Manawyrm/HB-LC-DimPWM-PCB/gerbers/RevA/HB-LC-DimPWM-PCB.png

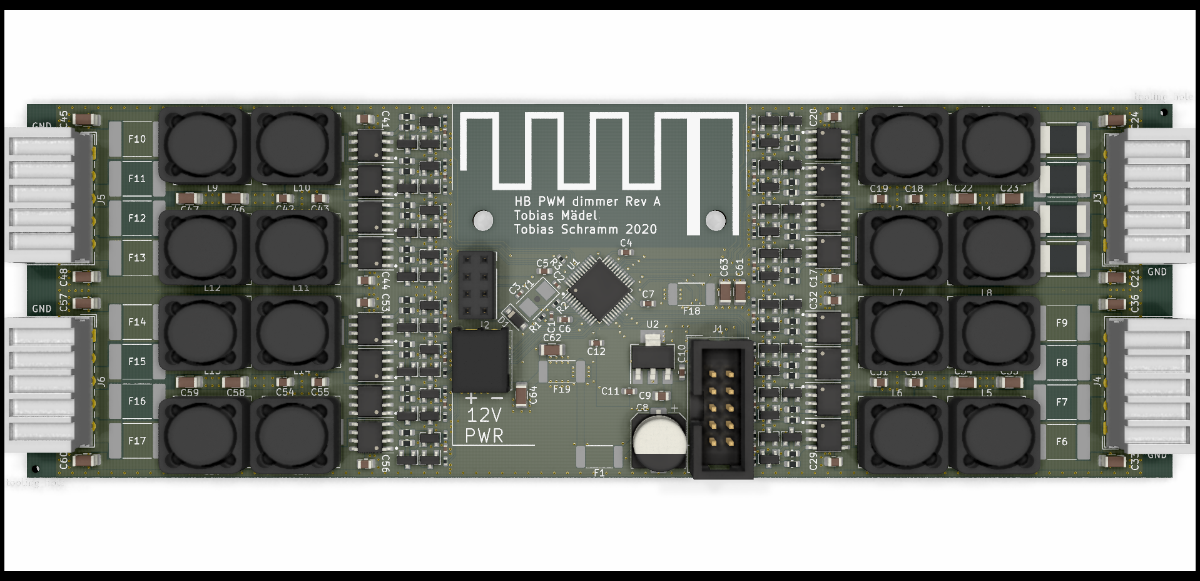
gerbers/RevA/HB-LC-DimPWM-PCB.png
