Manawyrm/HB-LC-DimPWM-PCB/README.md

HomeBrew 16 channel dimmer
==========================
