Manawyrm/HB-LC-DimPWM-PCB/HB-LC-DimPWM-PCB.kicad_pcb

## KiCad design HB-LC-DimPWM-PCB.kicad_pcb (2020-04-15)

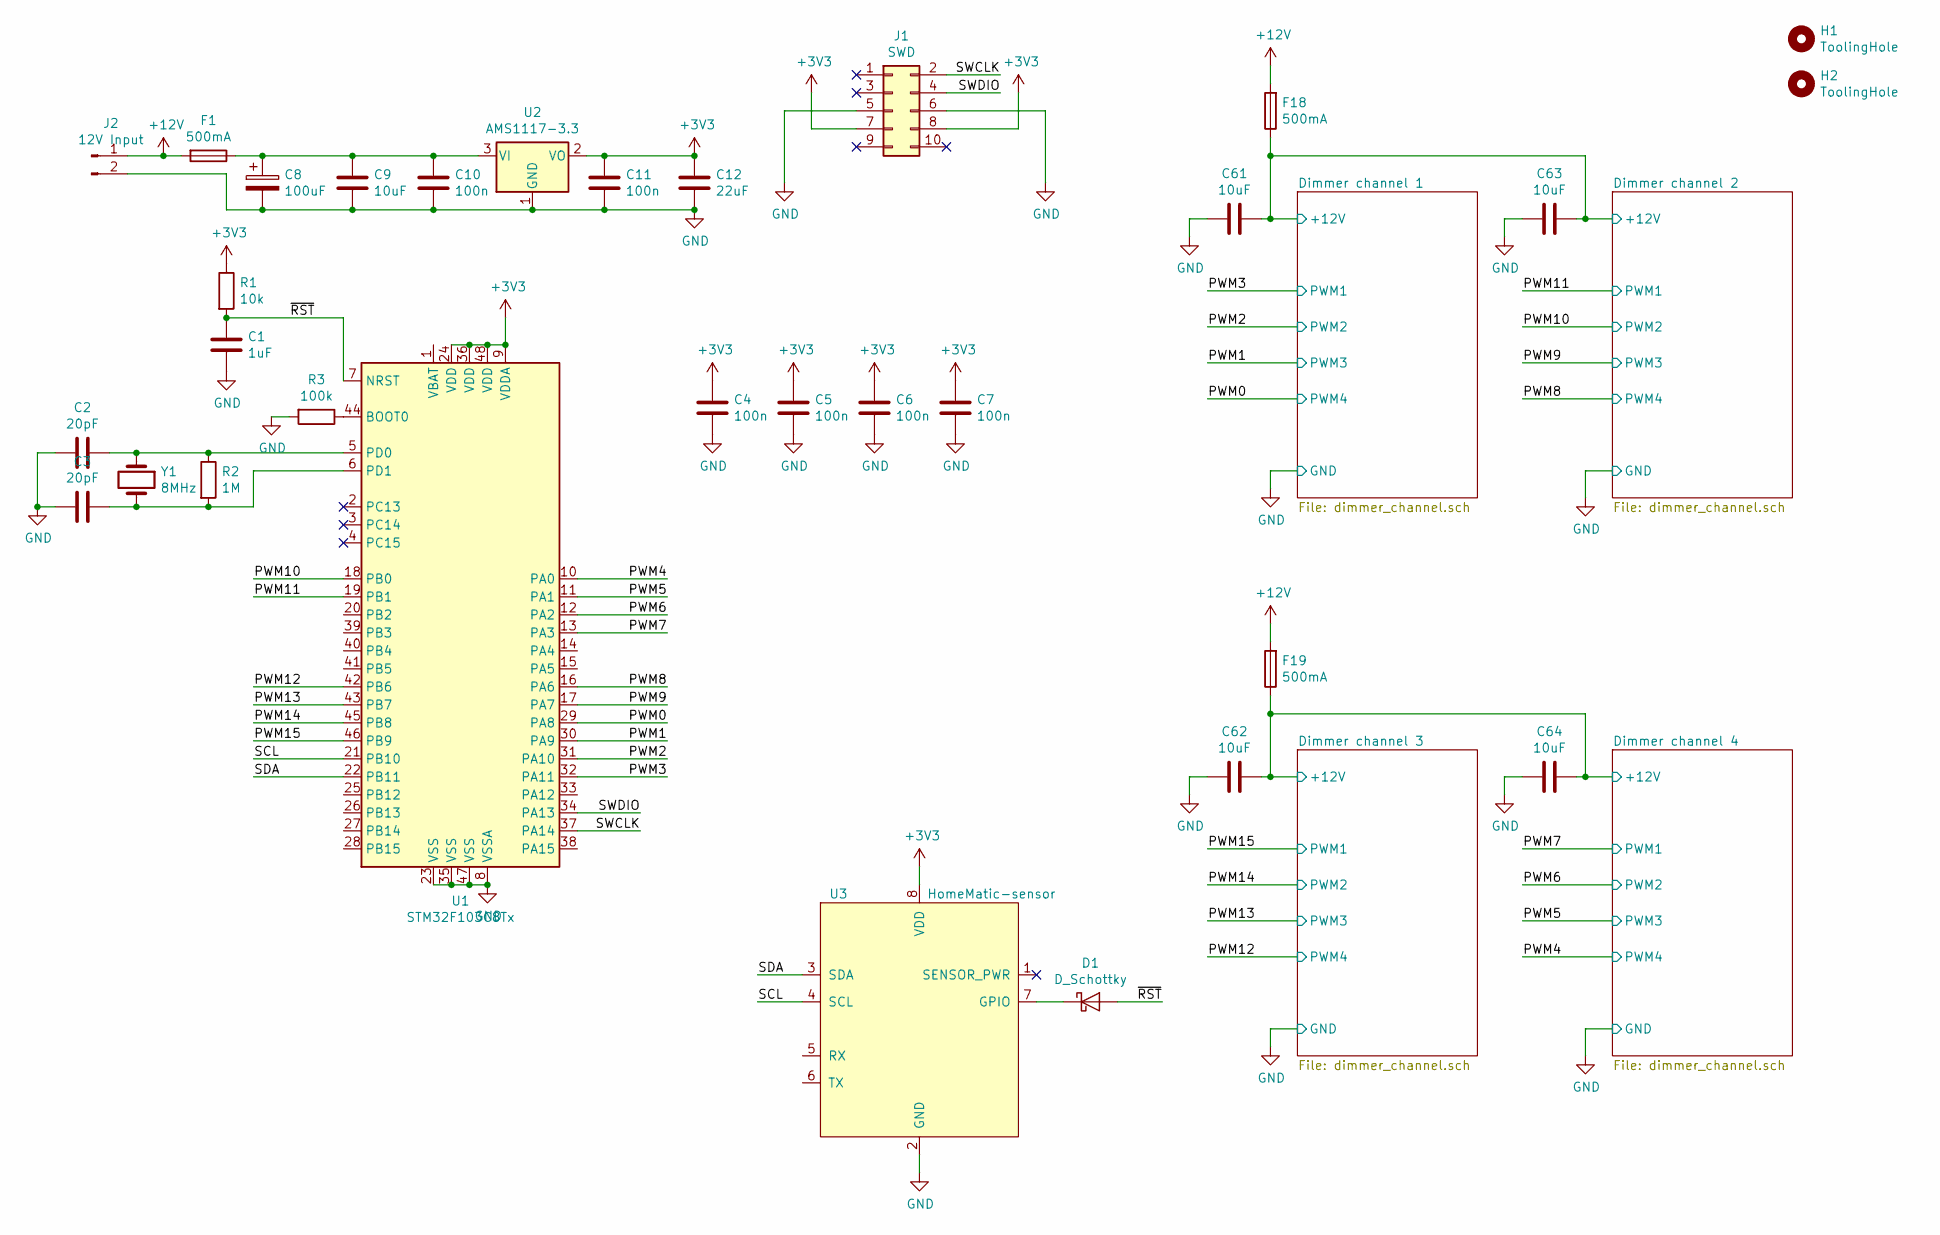
[picture p7: schematic HB-LC-DimPWM-PCB.sch, HB-LC-DimPWM]

Parts:
C1: 1uF; C_0402_1005Metric; LCSC C52923
C2, C3: 20pF; C_0402_1005Metric; LCSC C1554
C4, C5, C6, C7, C10, C11: 100n; C_0603_1608Metric; LCSC C14663
C8: 100uF; CP_Elec_8x6.7; LCSC C127967
C9: 10uF; C_0805_2012Metric; LCSC C15850
C12: 22uF; C_0603_1608Metric; LCSC C59461
C61, C62, C63, C64: 10uF; C_1206_3216Metric; LCSC C13585
D1: D_Schottky; D_SOD-123; LCSC C8598
F1, F18, F19: 500mA; Fuse_2512_6332Metric; LCSC C312001
H1, H2: ToolingHole; ToolingHole_JLCSMT
J1: SWD; IDC-Header_2x05_P2.54mm_Vertical
J2: 12V Input; Wago_714-162_1x02_P3.50mm_Horizontal
R1: 10k; R_0402_1005Metric; LCSC C25744
R2: 1M; R_0402_1005Metric; LCSC C26083
R3: 100k; R_0402_1005Metric; LCSC C25741
U1: STM32F103C8Tx; LQFP-48_7x7mm_P0.5mm; LCSC C8734
U2: AMS1117-3.3; SOT-223-3_TabPin2; LCSC C6186
U3: HomeMatic-sensor
Y1: 8MHz; Crystal_SMD_5032-2Pin_5.0x3.2mm; LCSC C115962

Connections:
+3V3: C4.1, C5.1, C6.1, C7.1, C11.1, C12.1, J1.7, J1.8, R1.1, U1.9 (VDDA), U1.24 (VDD), U1.36 (VDD), U1.48 (VDD), U2.2 (VO), U3.8 (VDD)
+12V: F1.2, F18.2, F19.2, J2.1
/Dimmer channel 1/+12V: C61.1, C63.1, F18.1; also elsewhere on the board
/Dimmer channel 3/+12V: C62.1, C64.1, F19.1; also elsewhere on the board
/PWM0: U1.29 (PA8); also elsewhere on the board
/PWM1: U1.30 (PA9); also elsewhere on the board
/PWM2: U1.31 (PA10); also elsewhere on the board
/PWM3: U1.32 (PA11); also elsewhere on the board
/PWM4: U1.10 (PA0); also elsewhere on the board
/PWM5: U1.11 (PA1); also elsewhere on the board
/PWM6: U1.12 (PA2); also elsewhere on the board
/PWM7: U1.13 (PA3); also elsewhere on the board
/PWM8: U1.16 (PA6); also elsewhere on the board
/PWM9: U1.17 (PA7); also elsewhere on the board
/PWM10: U1.18 (PB0); also elsewhere on the board
/PWM11: U1.19 (PB1); also elsewhere on the board
/PWM12: U1.42 (PB6); also elsewhere on the board
/PWM13: U1.43 (PB7); also elsewhere on the board
/PWM14: U1.45 (PB8); also elsewhere on the board
/PWM15: U1.46 (PB9); also elsewhere on the board
/SCL: U1.21 (PB10), U3.4 (SCL)
/SDA: U1.22 (PB11), U3.3 (SDA)
/SWCLK: J1.2, U1.37 (PA14)
/SWDIO: J1.4, U1.34 (PA13)
/~RST: C1.1, D1.2 (A), R1.2, U1.7 (NRST)
GND: C1.2, C2.1, C3.1, C4.2, C5.2, C6.2, C7.2, C8.2, C9.2, C10.2, C11.2, C12.2, C61.2, C62.2, C63.2, C64.2, J1.5, J1.6, J2.2, R3.2, U1.8 (VSSA), U1.23 (VSS), U1.35 (VSS), U1.47 (VSS), U2.1 (GND), U3.2 (GND); also elsewhere on the board
unnamed: C2.2, R2.1, U1.5 (PD0), Y1.1
unnamed: C3.2, R2.2, U1.6 (PD1), Y1.2
unnamed: C8.1, C9.1, C10.1, F1.1, U2.3 (VI)
unnamed: D1.1 (K), U3.7 (GPIO)
unnamed: R3.1, U1.44 (BOOT0)

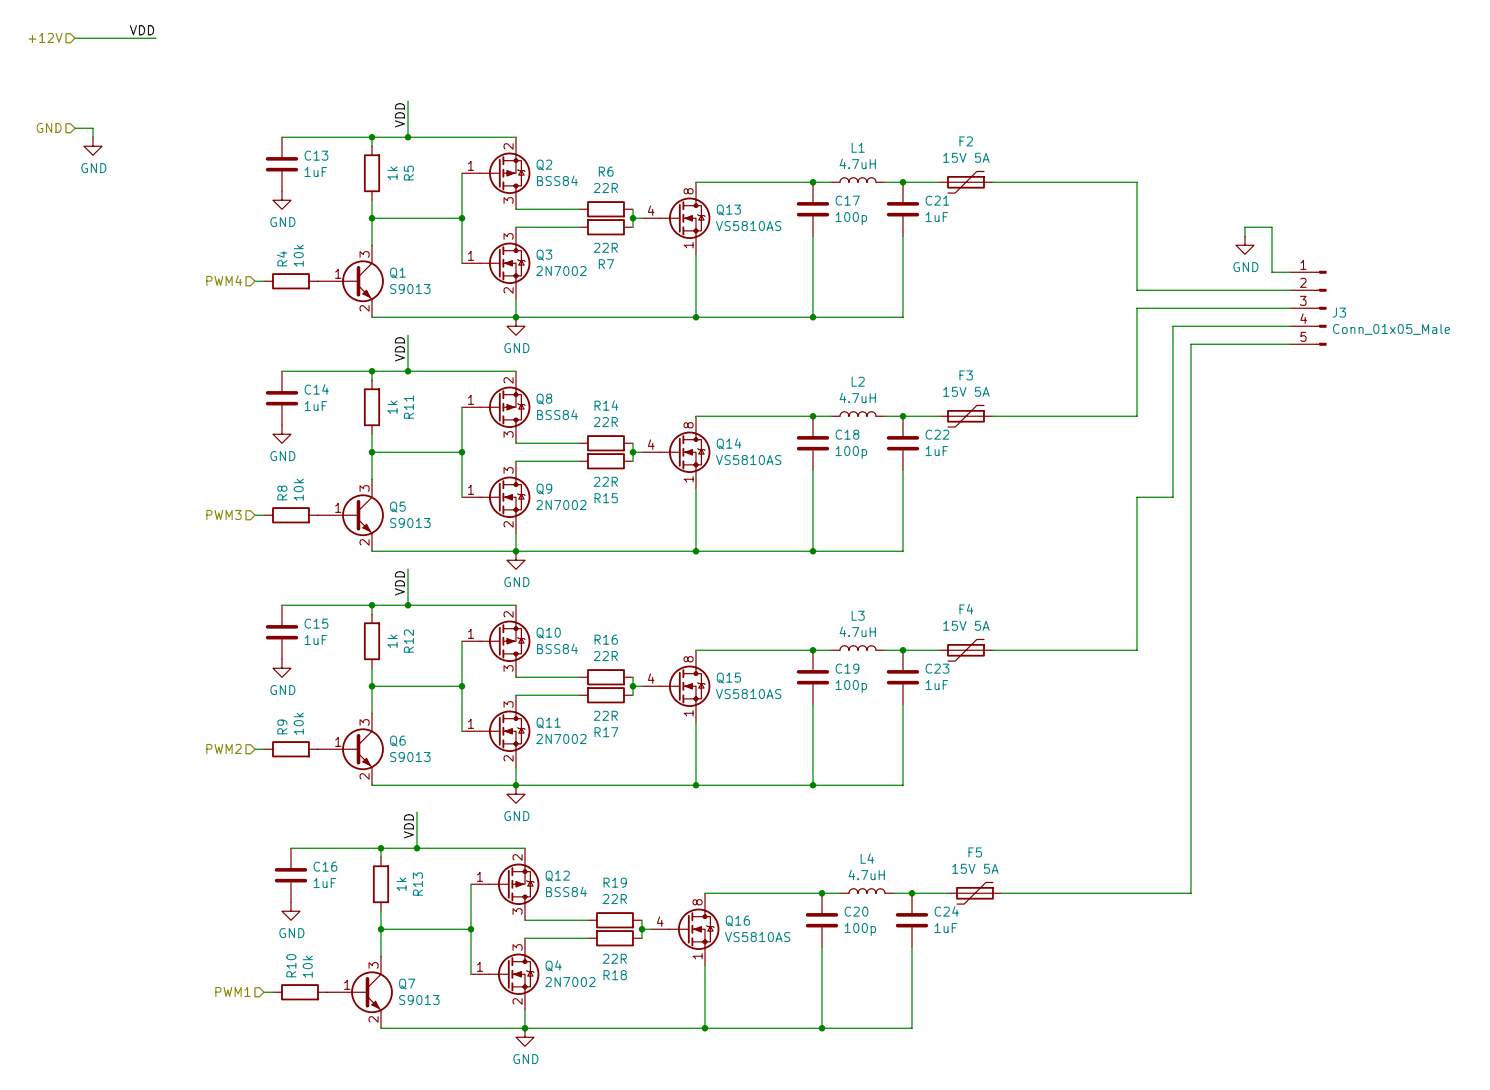
[picture p8: schematic dimmer_channel.sch, Dimmer channel]

Parts:
C13, C14, C15, C16: 1uF; C_0402_1005Metric; LCSC C52923
C17, C18, C19, C20: 100p; C_0805_2012Metric; LCSC C1790
C21, C22, C23, C24: 1uF; C_1206_3216Metric; LCSC C1848
F2, F3, F4, F5: 15V 5A; Fuse_2920_7451Metric; LCSC C207089
J3: Conn_01x05_Male; Wago_734-165_1x05_P3.50mm_Horizontal
L1, L2, L3, L4: 4.7uH; SMD-PIND-10.5x11.5x4_2.5x3.0; LCSC C183899
Q1, Q5, Q6, Q7: S9013; SOT-23; LCSC C6749
Q2, Q8, Q10, Q12: BSS84; SOT-23; LCSC C8492
Q3, Q4, Q9, Q11: 2N7002; SOT-23; LCSC C8545
Q13, Q14, Q15, Q16: VS5810AS; SOIC-8_3.9x4.9mm_P1.27mm; LCSC C427034
R4, R8, R9, R10: 10k; R_0402_1005Metric; LCSC C25744
R5, R11, R12, R13: 1k; R_0402_1005Metric; LCSC C11702
R6, R7, R14, R15, R16, R17, R18, R19: 22R; R_0603_1608Metric; LCSC C23345

Connections:
/Dimmer channel 1/+12V: C13.1, C14.1, C15.1, C16.1, Q2.2 (S), Q8.2 (S), Q10.2 (S), Q12.2 (S), R5.2, R11.2, R12.2, R13.2; also elsewhere on the board
/PWM0: R4.1; also elsewhere on the board
/PWM1: R8.1; also elsewhere on the board
/PWM2: R9.1; also elsewhere on the board
/PWM3: R10.1; also elsewhere on the board
GND: C13.2, C14.2, C15.2, C16.2, C17.2, C18.2, C19.2, C20.2, C21.2, C22.2, C23.2, C24.2, J3.1, Q1.2 (E), Q3.2 (S), Q4.2 (S), Q5.2 (E), Q6.2 (E), Q7.2 (E), Q9.2 (S), Q11.2 (S), Q13.1 (S), Q13.2 (S), Q13.3 (S), Q14.1 (S), Q14.2 (S), Q14.3 (S), Q15.1 (S), Q15.2 (S), Q15.3 (S), Q16.1 (S), Q16.2 (S), Q16.3 (S); also elsewhere on the board
unnamed: C17.1, L1.1, Q13.5 (D), Q13.6 (D), Q13.7 (D), Q13.8 (D)
unnamed: C18.1, L2.1, Q14.5 (D), Q14.6 (D), Q14.7 (D), Q14.8 (D)
unnamed: C19.1, L3.1, Q15.5 (D), Q15.6 (D), Q15.7 (D), Q15.8 (D)
unnamed: C20.1, L4.1, Q16.5 (D), Q16.6 (D), Q16.7 (D), Q16.8 (D)
unnamed: C21.1, F2.2, L1.2
unnamed: C22.1, F3.2, L2.2
unnamed: C23.1, F4.2, L3.2
unnamed: C24.1, F5.2, L4.2
unnamed: F2.1, J3.2
unnamed: F3.1, J3.3
unnamed: F4.1, J3.4
unnamed: F5.1, J3.5
unnamed: Q1.1 (B), R4.2
unnamed: Q1.3 (C), Q2.1 (G), Q3.1 (G), R5.1
unnamed: Q2.3 (D), R6.1
unnamed: Q3.3 (D), R7.2
unnamed: Q4.3 (D), R18.2
unnamed: Q5.1 (B), R8.2
unnamed: Q5.3 (C), Q8.1 (G), Q9.1 (G), R11.1
unnamed: Q6.1 (B), R9.2
unnamed: Q7.1 (B), R10.2
unnamed: Q8.3 (D), R14.1
unnamed: Q9.3 (D), R15.2
unnamed: Q6.3 (C), Q10.1 (G), Q11.1 (G), R12.1
unnamed: Q10.3 (D), R16.1
unnamed: Q11.3 (D), R17.2
unnamed: Q4.1 (G), Q7.3 (C), Q12.1 (G), R13.1
unnamed: Q12.3 (D), R19.1
unnamed: Q13.4 (G), R6.2, R7.1
unnamed: Q14.4 (G), R14.2, R15.1
unnamed: Q15.4 (G), R16.2, R17.1
unnamed: Q16.4 (G), R18.1, R19.2

Parts of its further copies:
C25, C26, C27, C28, C37, C38, C39, C40, C49, C50, C51, C52: 1uF; C_0402_1005Metric; LCSC C52923
C29, C30, C31, C32, C41, C42, C43, C44, C53, C54, C55, C56: 100p; C_0805_2012Metric; LCSC C1790
C33, C34, C35, C36, C45, C46, C47, C48, C57, C58, C59, C60: 1uF; C_1206_3216Metric; LCSC C1848
F6, F7, F8, F9, F10, F11, F12, F13, F14, F15, F16, F17: 15V 5A; Fuse_2920_7451Metric; LCSC C207089
J4, J5, J6: Conn_01x05_Male; Wago_734-165_1x05_P3.50mm_Horizontal
Q17, Q18, Q19, Q20, Q33, Q34, Q35, Q36, Q49, Q50, Q51, Q52: S9013; SOT-23; LCSC C6749
Q21, Q23, Q25, Q27, Q37, Q39, Q41, Q43, Q53, Q55, Q57, Q59: BSS84; SOT-23; LCSC C8492
Q22, Q24, Q26, Q28, Q38, Q40, Q42, Q44, Q54, Q56, Q58, Q60: 2N7002; SOT-23; LCSC C8545
Q29, Q30, Q31, Q32, Q45, Q46, Q47, Q48, Q61, Q62, Q63, Q64: VS5810AS; SOIC-8_3.9x4.9mm_P1.27mm; LCSC C427034
R20, R21, R22, R23, R36, R37, R38, R39, R52, R53, R54, R55: 10k; R_0402_1005Metric; LCSC C25744
R24, R25, R26, R27, R40, R41, R42, R43, R56, R57, R58, R59: 1k; R_0402_1005Metric; LCSC C11702
R28, R29, R30, R31, R32, R33, R34, R35, R44, R45, R46, R47, R48, R49, R50, R51, R60, R61, R62, R63, R64, R65, R66, R67: 22R; R_0603_1608Metric; LCSC C23345

Connections of its further copies:
/Dimmer channel 1/+12V: C25.1, C26.1, C27.1, C28.1, Q21.2 (S), Q23.2 (S), Q25.2 (S), Q27.2 (S), R24.2, R25.2, R26.2, R27.2; also elsewhere on the board
/Dimmer channel 3/+12V: C37.1, C38.1, C39.1, C40.1, C49.1, C50.1, C51.1, C52.1, Q37.2 (S), Q39.2 (S), Q41.2 (S), Q43.2 (S), Q53.2 (S), Q55.2 (S), Q57.2 (S), Q59.2 (S), R40.2, R41.2, R42.2, R43.2, R56.2, R57.2, R58.2, R59.2; also elsewhere on the board
/PWM4: R52.1; also elsewhere on the board
/PWM5: R53.1; also elsewhere on the board
/PWM6: R54.1; also elsewhere on the board
/PWM7: R55.1; also elsewhere on the board
/PWM8: R20.1; also elsewhere on the board
/PWM9: R21.1; also elsewhere on the board
/PWM10: R22.1; also elsewhere on the board
/PWM11: R23.1; also elsewhere on the board
/PWM12: R36.1; also elsewhere on the board
/PWM13: R37.1; also elsewhere on the board
/PWM14: R38.1; also elsewhere on the board
/PWM15: R39.1; also elsewhere on the board
GND: C25.2, C26.2, C27.2, C28.2, C29.2, C30.2, C31.2, C32.2, C33.2, C34.2, C35.2, C36.2, C37.2, C38.2, C39.2, C40.2, C41.2, C42.2, C43.2, C44.2, C45.2, C46.2, C47.2, C48.2, C49.2, C50.2, C51.2, C52.2, C53.2, C54.2, C55.2, C56.2, C57.2, C58.2, C59.2, C60.2, J4.1, J5.1, J6.1, Q17.2 (E), Q18.2 (E), Q19.2 (E), Q20.2 (E), Q22.2 (S), Q24.2 (S), Q26.2 (S), Q28.2 (S), Q29.1 (S), Q29.2 (S), Q29.3 (S), Q30.1 (S), Q30.2 (S), Q30.3 (S), Q31.1 (S), Q31.2 (S), Q31.3 (S), Q32.1 (S), Q32.2 (S), Q32.3 (S), Q33.2 (E), Q34.2 (E), Q35.2 (E), Q36.2 (E), Q38.2 (S), Q40.2 (S), Q42.2 (S), Q44.2 (S), Q45.1 (S), Q45.2 (S), Q45.3 (S), Q46.1 (S), Q46.2 (S), Q46.3 (S), Q47.1 (S), Q47.2 (S), Q47.3 (S), Q48.1 (S), Q48.2 (S), Q48.3 (S), Q49.2 (E), Q50.2 (E), Q51.2 (E), Q52.2 (E), Q54.2 (S), Q56.2 (S), Q58.2 (S), Q60.2 (S), Q61.1 (S), Q61.2 (S), Q61.3 (S), Q62.1 (S), Q62.2 (S), Q62.3 (S), Q63.1 (S), Q63.2 (S), Q63.3 (S), Q64.1 (S), Q64.2 (S), Q64.3 (S); also elsewhere on the board
unnamed 37: C29.1, Q29.5 (D), Q29.6 (D), Q29.7 (D), Q29.8 (D); also elsewhere on the board
unnamed 38: C30.1, Q30.5 (D), Q30.6 (D), Q30.7 (D), Q30.8 (D); also elsewhere on the board
unnamed 39: C31.1, Q31.5 (D), Q31.6 (D), Q31.7 (D), Q31.8 (D); also elsewhere on the board
unnamed 40: C32.1, Q32.5 (D), Q32.6 (D), Q32.7 (D), Q32.8 (D); also elsewhere on the board
unnamed 41: C33.1, F6.2; also elsewhere on the board
unnamed 42: C34.1, F7.2; also elsewhere on the board
unnamed 43: C35.1, F8.2; also elsewhere on the board
unnamed 44: C36.1, F9.2; also elsewhere on the board
unnamed 45: C41.1, Q45.5 (D), Q45.6 (D), Q45.7 (D), Q45.8 (D); also elsewhere on the board
unnamed 46: C42.1, Q46.5 (D), Q46.6 (D), Q46.7 (D), Q46.8 (D); also elsewhere on the board
unnamed 47: C43.1, Q47.5 (D), Q47.6 (D), Q47.7 (D), Q47.8 (D); also elsewhere on the board
unnamed 48: C44.1, Q48.5 (D), Q48.6 (D), Q48.7 (D), Q48.8 (D); also elsewhere on the board
unnamed 49: C45.1, F10.2; also elsewhere on the board
unnamed 50: C46.1, F11.2; also elsewhere on the board
unnamed 51: C47.1, F12.2; also elsewhere on the board
unnamed 52: C48.1, F13.2; also elsewhere on the board
unnamed 53: C53.1, Q61.5 (D), Q61.6 (D), Q61.7 (D), Q61.8 (D); also elsewhere on the board
unnamed 54: C54.1, Q62.5 (D), Q62.6 (D), Q62.7 (D), Q62.8 (D); also elsewhere on the board
unnamed 55: C55.1, Q63.5 (D), Q63.6 (D), Q63.7 (D), Q63.8 (D); also elsewhere on the board
unnamed 56: C56.1, Q64.5 (D), Q64.6 (D), Q64.7 (D), Q64.8 (D); also elsewhere on the board
unnamed 57: C57.1, F14.2; also elsewhere on the board
unnamed 58: C58.1, F15.2; also elsewhere on the board
unnamed 59: C59.1, F16.2; also elsewhere on the board
unnamed 60: C60.1, F17.2; also elsewhere on the board
unnamed: F6.1, J4.2
unnamed: F7.1, J4.3
unnamed: F8.1, J4.4
unnamed: F9.1, J4.5
unnamed: F10.1, J5.2
unnamed: F11.1, J5.3
unnamed: F12.1, J5.4
unnamed: F13.1, J5.5
unnamed: F14.1, J6.2
unnamed: F15.1, J6.3
unnamed: F16.1, J6.4
unnamed: F17.1, J6.5
unnamed: Q17.1 (B), R20.2
unnamed: Q17.3 (C), Q21.1 (G), Q22.1 (G), R24.1
unnamed: Q18.1 (B), R21.2
unnamed: Q18.3 (C), Q23.1 (G), Q24.1 (G), R25.1
unnamed: Q19.1 (B), R22.2
unnamed: Q19.3 (C), Q25.1 (G), Q26.1 (G), R26.1
unnamed: Q20.1 (B), R23.2
unnamed: Q20.3 (C), Q27.1 (G), Q28.1 (G), R27.1
unnamed: Q21.3 (D), R28.1
unnamed: Q22.3 (D), R29.2
unnamed: Q23.3 (D), R30.1
unnamed: Q24.3 (D), R31.2
unnamed: Q25.3 (D), R32.1
unnamed: Q26.3 (D), R33.2
unnamed: Q27.3 (D), R34.1
unnamed: Q28.3 (D), R35.2
unnamed: Q29.4 (G), R28.2, R29.1
unnamed: Q30.4 (G), R30.2, R31.1
unnamed: Q31.4 (G), R32.2, R33.1
unnamed: Q32.4 (G), R34.2, R35.1
unnamed: Q33.1 (B), R36.2
unnamed: Q33.3 (C), Q37.1 (G), Q38.1 (G), R40.1
unnamed: Q34.1 (B), R37.2
unnamed: Q34.3 (C), Q39.1 (G), Q40.1 (G), R41.1
unnamed: Q35.1 (B), R38.2
unnamed: Q35.3 (C), Q41.1 (G), Q42.1 (G), R42.1
unnamed: Q36.1 (B), R39.2
unnamed: Q36.3 (C), Q43.1 (G), Q44.1 (G), R43.1
unnamed: Q37.3 (D), R44.1
unnamed: Q38.3 (D), R45.2
unnamed: Q39.3 (D), R46.1
unnamed: Q40.3 (D), R47.2
unnamed: Q41.3 (D), R48.1
unnamed: Q42.3 (D), R49.2
unnamed: Q43.3 (D), R50.1
unnamed: Q44.3 (D), R51.2
unnamed: Q45.4 (G), R44.2, R45.1
unnamed: Q46.4 (G), R46.2, R47.1
unnamed: Q47.4 (G), R48.2, R49.1
unnamed: Q48.4 (G), R50.2, R51.1
unnamed: Q49.1 (B), R52.2
unnamed: Q49.3 (C), Q53.1 (G), Q54.1 (G), R56.1
unnamed: Q50.1 (B), R53.2
unnamed: Q50.3 (C), Q55.1 (G), Q56.1 (G), R57.1
unnamed: Q51.1 (B), R54.2
unnamed: Q51.3 (C), Q57.1 (G), Q58.1 (G), R58.1
unnamed: Q52.1 (B), R55.2
unnamed: Q52.3 (C), Q59.1 (G), Q60.1 (G), R59.1
unnamed: Q53.3 (D), R60.1
unnamed: Q54.3 (D), R61.2
unnamed: Q55.3 (D), R62.1
unnamed: Q56.3 (D), R63.2
unnamed: Q57.3 (D), R64.1
unnamed: Q58.3 (D), R65.2
unnamed: Q59.3 (D), R66.1
unnamed: Q60.3 (D), R67.2
unnamed: Q61.4 (G), R60.2, R61.1
unnamed: Q62.4 (G), R62.2, R63.1
unnamed: Q63.4 (G), R64.2, R65.1
unnamed: Q64.4 (G), R66.2, R67.1

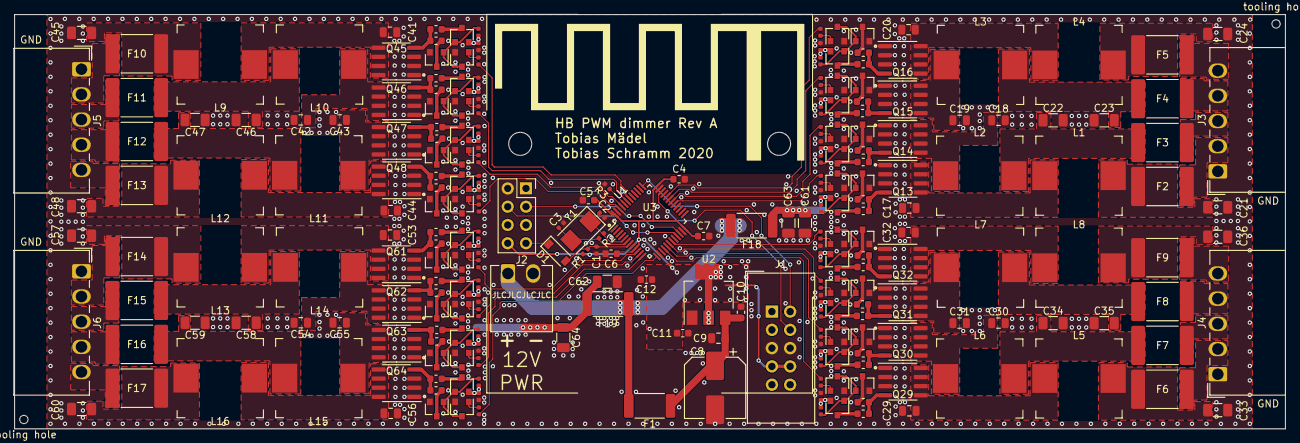
[picture p9: board HB-LC-DimPWM-PCB.kicad_pcb from above]

Board: 2 copper layers, 176.7 x 57.6 mm, 243 parts (0 on the bottom side), 159 nets.

Other parts of the board:
L5, L6, L7, L8, L9, L10, L11, L12, L13, L14, L15, L16: 3.3uH; SMD-PIND-10.5x11.5x4_2.5x3.0

Their connections:
unnamed 37: L5.1; also elsewhere on the board
unnamed 38: L6.1; also elsewhere on the board
unnamed 39: L7.1; also elsewhere on the board
unnamed 40: L8.1; also elsewhere on the board
unnamed 41: L5.2; also elsewhere on the board
unnamed 42: L6.2; also elsewhere on the board
unnamed 43: L7.2; also elsewhere on the board
unnamed 44: L8.2; also elsewhere on the board
unnamed 45: L9.1; also elsewhere on the board
unnamed 46: L10.1; also elsewhere on the board
unnamed 47: L11.1; also elsewhere on the board
unnamed 48: L12.1; also elsewhere on the board
unnamed 49: L9.2; also elsewhere on the board
unnamed 50: L10.2; also elsewhere on the board
unnamed 51: L11.2; also elsewhere on the board
unnamed 52: L12.2; also elsewhere on the board
unnamed 53: L13.1; also elsewhere on the board
unnamed 54: L14.1; also elsewhere on the board
unnamed 55: L15.1; also elsewhere on the board
unnamed 56: L16.1; also elsewhere on the board
unnamed 57: L13.2; also elsewhere on the board
unnamed 58: L14.2; also elsewhere on the board
unnamed 59: L15.2; also elsewhere on the board
unnamed 60: L16.2; also elsewhere on the board
