Manawyrm/HB-LC-DimPWM-PCB/(commit log)

2020-03-29 Add alternate gate driver setup
    [HB-LC-DimPWM-PCB.kicad_pcb, HB-LC-DimPWM-PCB.sch]
2020-04-03 Layout one dimmer channel
    [HB-LC-DimPWM-PCB.kicad_pcb, HB-LC-DimPWM-PCB.sch]
2020-04-03 Optimize channel layout
    [HB-LC-DimPWM-PCB.kicad_pcb]
2020-04-03 Add more space for GND vias below dimmer FETs
    [HB-LC-DimPWM-PCB.kicad_pcb]
2020-04-03 Add full layout as PoC
    [HB-LC-DimPWM-PCB.kicad_pcb, HB-LC-DimPWM-PCB.sch]
2020-04-03 Update sensor model
    [HB-LC-DimPWM-PCB.kicad_pcb]
2020-04-04 Move dimmer channels to subsheet
    [dimmer_channel.sch]
2020-04-04 Use hierarchical sheet for dimmer channels
    [HB-LC-DimPWM-PCB.sch]
2020-04-04 Finish layout of first four dimmer channels
    [HB-LC-DimPWM-PCB.kicad_pcb]
2020-04-04 Reduce solder mask clearance to 0
    [HB-LC-DimPWM-PCB.kicad_pcb]
2020-04-04 First eight channels finished
    [HB-LC-DimPWM-PCB.kicad_pcb, HB-LC-DimPWM-PCB.sch]
2020-04-04 All 16 channels layouted
    [HB-LC-DimPWM-PCB.kicad_pcb]
2020-04-04 Replace 5.08 mm pitch headers by 3.5 mm pitch
    [HB-LC-DimPWM-PCB.kicad_pcb, HB-LC-DimPWM-PCB.sch, dimmer_channel.sch]
2020-04-04 Add wago 714 connectors
2020-04-04 Layout board
    [HB-LC-DimPWM-PCB.kicad_pcb, HB-LC-DimPWM-PCB.sch, dimmer_channel.sch]
2020-04-04 Add wago 734 3d models
    [HB-LC-DimPWM-PCB.kicad_pcb]
2020-04-05 Internal kicad reordering
    No idea why that happened
    [dimmer_channel.sch]
2020-04-05 Add additional bypassing
    Add 4x 10uF to gate driver supplies
    [HB-LC-DimPWM-PCB.sch]
2020-04-05 Add tons of manual via stitching
    [HB-LC-DimPWM-PCB.kicad_pcb]
2020-04-05 Add pin 1 markers
    [HB-LC-DimPWM-PCB.kicad_pcb]
2020-04-05 Remove vias too close to one another for safe drilling
    [HB-LC-DimPWM-PCB.kicad_pcb]
2020-04-05 Mark GND pin on lamp connectors
    [HB-LC-DimPWM-PCB.kicad_pcb]
2020-04-05 Add revision indicator
    [HB-LC-DimPWM-PCB.kicad_pcb]
2020-04-05 Add PWM channel designators
    [HB-LC-DimPWM-PCB.kicad_pcb]
2020-04-05 Include HB sensor lib via relative path
2020-04-05 Add metadata to schematic
    [HB-LC-DimPWM-PCB.sch, dimmer_channel.sch]
2020-04-05 Remove rescue lib
    [HB-LC-DimPWM-PCB.sch]
2020-04-05 Add tooling holes
    [HB-LC-DimPWM-PCB.kicad_pcb, HB-LC-DimPWM-PCB.sch, dimmer_channel.sch]
2020-04-05 Fix GND marking orientation
    [HB-LC-DimPWM-PCB.kicad_pcb]
2020-04-05 Change inductor to 4.7uH for JLC assembly
    [dimmer_channel.sch]
2020-04-05 Add path configuration for gerber output
    [HB-LC-DimPWM-PCB.kicad_pcb]
2020-04-05 Add gerbers, PDF schematics and render image for RevA
    [HB-LC-DimPWM-PCB-B_Cu.gbl, HB-LC-DimPWM-PCB-B_Mask.gbs, HB-LC-DimPWM-PCB-B_Paste.gbp, HB-LC-DimPWM-PCB-B_SilkS.gbo, HB-LC-DimPWM-PCB-Edge_Cuts.gm1, HB-LC-DimPWM-PCB-F_Cu.gtl, HB-LC-DimPWM-PCB-F_Mask.gts, HB-LC-DimPWM-PCB-F_Paste.gtp]
2020-04-05 Fix orientation of polymer cap for JLC
    [HB-LC-DimPWM-PCB_cpl_jlc.csv]
2020-04-05 Add interactive HTML bom
2020-04-06 Fix 1206 component with 0603 LCSC part number (1uF cap)
    [dimmer_channel.sch]
2020-04-06 Add new fixed production data for JLC
    [HB-LC-DimPWM-PCB_bom_jlc.csv]
2020-04-07 Add missing 3d models
    [HB-LC-DimPWM-PCB.kicad_pcb]
2020-04-07 Fix possible collision between sensor module and F19
    Height of F19 is 2.6 mm, could collide with ISP header if not centered properly
    [HB-LC-DimPWM-PCB.kicad_pcb]
2020-04-07 Set default via drill hole size to .3 mm
2020-04-07 Resize fuse 3d models for more realistic 3d view
    [HB-LC-DimPWM-PCB.kicad_pcb]
2020-04-07 Allign dimmer channels on schematic
    [HB-LC-DimPWM-PCB.sch]
2020-04-07 Use 3d inductor model closer to actual inductor used
    [HB-LC-DimPWM-PCB.kicad_pcb]
2020-04-15 Move designator C62 to unobstructed place
    [HB-LC-DimPWM-PCB.kicad_pcb]
2020-04-22 Remove duplicate LCSC part number
    [HB-LC-DimPWM-PCB.sch]
